Feanor1021/MSP430G2553-Distance-measurement-with-HC-05-bluetooth-module/(list of files, drawings)

Other design files:
PCB/MAASTER.SchDoc
PCB/PCB2.PcbDoc
PCB/PCB_Project_1.PrjPcb
